LoretteHorter/Test-bench/Doc/5A125VAC-3A250VAC.jpg

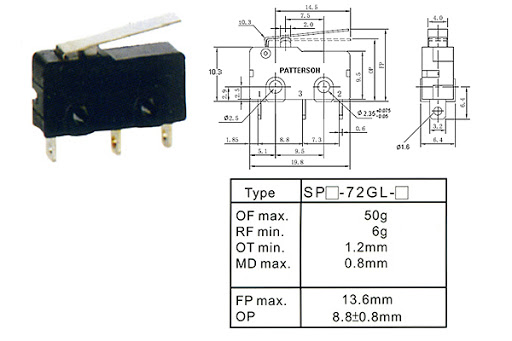
Doc/5A125VAC-3A250VAC.jpg
