LoretteHorter/Test-bench/Doc/procedure de test.pdf

Prepared by | Laurie VDS Lorette HORTER | TEST PROCEDURE
Date | 04/03/20

With all elements that compose the distance sensor test bench and its programs, you will be able to check if the distance sensor measures the right distances.

### Before, the realisation of the test bench had to be realised, thanks to the step by step

procedure document.

Time required for the assembly of the test bench : 4h (explained on step by step procedure

### document) Time required for the program tests : 1h Time to realise one test of the sensor : 10min

## TABLE OF CONTENT :

Programs recovery | 2
Tests procedure | 3

## DOCUMENT HISTORY

INDEX | DATE | MODIFICATIONS | VISA
A | 12/02/20 | Document creation
B | 04/03/20 | First edit
Id. B | 04/03/20 | TEST PROCEDURE | Page 1

# Programs recovery

### To make the test bench operational, it is necessary to program an arduino card as

the one that is connected to the test bench on the step by step procedure. The results of the test will be displayed on the arduino terminal of the laptop.

Be sure to have an arduino program installed on your laptop, and that you can connect your arduino card on it.

### We have tree programs to realise the sensor test : - “code_ capteur_temp” to check if the temperature is good to realise a good test - “code_moteur” to make the DC test bench motor move correctly - “CODE_capteur_distance” to display if the test is successful or failed

These tree programs are working with an arduino card because we already test it. With all the programs recovered, first the temperature program has to be executed.

### Then, the DC motor program will be executed to permit the test program to display the

results.

Id. B | 04/03/20 | TEST PROCEDURE | Page 2

# Tests procedure

## TEST NUMBER ONE

Date : xx/xx/xxxx | (insert testers name)
Title : TEST FOR THE TEMPERATURE | Object : To check the temperature before the sensor test.

### PROGRAM INSTALLATION :

Software used :
- Arduino program

Version :
non important

Operating mode :

Steps | Demarche | Why ? | Expected response | OK ?
1 | Enter the “code_capteur_temp” program on the arduino program and compile it. | To check if the program is accepted and will work. | “Compilation done” + no warning and error.
2 | Televerse the program on the arduino card by an usb cable. | To send the program at the arduino to runs it. | “Televerse complete” + no warning and error.
3 | Open the arduino terminal and check if the informations sent by the temperature are displayed. | To display the result on a laptop. | “Temperature is …”

### TEST RESULTS :

Check it with the displayed result :
If it works :
Result | OK ?

Temperature = 20 ± 2°c

If it’s failed :

Result | Recommandation | OK ?

Temperature
< 20

increase room
temperature
Temperature > 20 | decrease room temperature
No temperature | Check the wiring of the entire test bench.

To conclude : indicate if the test is successful or failed.

Id. B | 04/03/20 | TEST PROCEDURE | Page 3

## TEST NUMBER TWO

Date : xx/xx/xxxx | (insert testers name)
Title : TEST FOR THE DC MOTOR | Object : To check if the DC motor works on the entire test bench.

### PROGRAM INSTALLATION :

Software used :
- Arduino program

Version :
non important

Operating mode :

Steps | Demarche | Why ? | Expected response | OK ?
1 | Enter the “code_moteur” program on the arduino program and compile it. | To check if the program is accepted and will work. | “Compilation done” + no warning and error.
2 | Televerse the program on the arduino card by an usb cable. | To send the program at the arduino to runs it. | “Televerse complete” + no warning and error.
3 | Check if the motor makes all treadmill moves on the entire test bench. | To be sure that the DC motor will be efficient for the sensor test. | It moves for the entire test bench.

### TEST RESULTS :

Check it with the displayed result :
If it works :
Result | OK ?

Moves on the entire test bench.

If it’s failed :

Result | Recommandation | OK ?
No move | Re-compile and
re-televerse the
program after
checking if the arduino
card is well detected
by the arduino
program.
Check the wiring of
the entire test bench.

To conclude : indicate if the test is successful or failed.

Id. B | 04/03/20 | TEST PROCEDURE | Page 4

## TEST NUMBER TREE

Date : xx/xx/xxxx | (insert testers name)
Title : TEST FOR THE DISTANCE SENSOR | Object : To check if the sensor measures the real distances.

### PROGRAM INSTALLATION :

Software used :
- Arduino program

Version :
non important

Operating mode :

Steps | Demarche | Why ? | Expected response | OK ?
1 | Enter the “CODE_capteur_distance” program on the arduino program and compile it. | To check if the program is accepted and will work. | “Compilation done” + no warning and error.
2 | Televerse the program on the arduino card by an usb cable. | To send the program at the arduino to runs it. | “Televerse complete” + no warning and error.
3 | Check if the sensor does its measures correctly. | To be sure that the sensor is operational. | " distance :... cm"

### TEST RESULTS :

Check it with the displayed result :
If it works :
Result | OK ?

When the conveyor belt is close to the sensor :
5cm .

When the conveyor belt is far from the sensor : 40 cm .

If it’s failed :

Result | Recommandation | OK ?

No
measure

Re-compile and
re-televerse the
program after
checking if the
arduino card is well
detected by the
arduino program.

Wrong
measures

Check the wiring of
the entire test bench.

To conclude : indicate if the test is successful or failed.

Id. B | 04/03/20 | TEST PROCEDURE | Page 5
